beriberikix/spotmicro-arduino-q/stl/README.md

# Printable parts

Generated by `scripts/export_stls.py`; do not edit by hand.
Print every part without supports at 0.2 mm layers. Quantities are per robot.
`_mirrored` files are the mirrored copies of parts that come in pairs: normal files for the left legs, `_mirrored` for the right legs (the shoulder servo mount takes one of each per side).
Every part is in its print orientation, centred, with its lowest point at Z = 0.

Sources and licenses: Kooba's SpotMicroESP32 and robjk's reinforced shoulders (CC BY, Thingiverse
thing:4559827 and thing:4937631), the helper stand from Leika (stefi01, CC BY 4.0; Nova-SM2, MIT), and
`electronics/UnoQ_Mountingplate.stl` and `head/Sensormount_DualCam.stl` (this project, modified from Kooba,
CC BY-SA 4.0). See ../NOTICE.md.

## chassis

| File | Normal | Mirrored | Material | Infill | Notes |
| ---- | --- | --- | --- | --- | ----- |
| [Inner_Shoulder.stl](chassis/Inner_Shoulder.stl) | 2 | - | PLA | 20% |  |
| [Outer_Shoulder.stl](chassis/Outer_Shoulder.stl) | 2 | - | PLA | 20% |  |
| [Chassis_Side.stl](chassis/Chassis_Side.stl) | 2 | - | PLA | 20% |  |
| [Top_Shoulder.stl](chassis/Top_Shoulder.stl) | 2 | - | PLA | 20% |  |
| [Bottom_Shoulder.stl](chassis/Bottom_Shoulder.stl) | 2 | - | PLA | 20% |  |
| [LiPo_Mountingbracket_Front.stl](chassis/LiPo_Mountingbracket_Front.stl) | 1 | - | PLA | 20% |  |
| [LiPo_Mountingbracket_Middle.stl](chassis/LiPo_Mountingbracket_Middle.stl) | 1 | - | PLA | 20% |  |
| [LiPo_Mountingbracket_Rear.stl](chassis/LiPo_Mountingbracket_Rear.stl) | 1 | - | PLA | 20% |  |

## electronics

| File | Normal | Mirrored | Material | Infill | Notes |
| ---- | --- | --- | --- | --- | ----- |
| [UnoQ_Mountingplate.stl](electronics/UnoQ_Mountingplate.stl) | 1 | - | PLA | 20% | New: UNO Media Carrier + UNO Q + servo shield stack, SZBK07, GY-521 |

## shoulders

| File | Normal | Mirrored | Material | Infill | Notes |
| ---- | --- | --- | --- | --- | ----- |
| [Shoulder_Joint_Servomount_extended_BB.stl](shoulders/Shoulder_Joint_Servomount_extended_BB.stl) · [Shoulder_Joint_Servomount_extended_BB_mirrored.stl](shoulders/Shoulder_Joint_Servomount_extended_BB_mirrored.stl) | 2 | 2 | PLA | 20% | robjk |
| [Shoulder_Joint_Servo_Cap_Extended.stl](shoulders/Shoulder_Joint_Servo_Cap_Extended.stl) | 4 | - | PLA | 20% | robjk |
| [Shoulder_Cover.stl](shoulders/Shoulder_Cover.stl) | 4 | - | PLA | 20% | robjk; symmetric, no mirrored copy |
| [Shoulder_Joint_Ball_Bearing_Pin_M3x8.stl](shoulders/Shoulder_Joint_Ball_Bearing_Pin_M3x8.stl) | 4 | - | PLA | 20% | robjk; runs in the shoulder-cover bearing, M3x8 into the upper-leg shell |
| [Shoulder_Joint_Ball_Bearing_Pin.stl](shoulders/Shoulder_Joint_Ball_Bearing_Pin.stl) | 8 | - | PLA | 20% | 4 for the shoulder joints, 4 for the legs |

## legs

| File | Normal | Mirrored | Material | Infill | Notes |
| ---- | --- | --- | --- | --- | ----- |
| [Limb_Top_Shell_with_BB_hole.stl](legs/Limb_Top_Shell_with_BB_hole.stl) · [Limb_Top_Shell_with_BB_hole_mirrored.stl](legs/Limb_Top_Shell_with_BB_hole_mirrored.stl) | 2 | 2 | PLA | 20% | robjk; replaces Limb_Top_Shell |
| [Limb_Bottom_Shell.stl](legs/Limb_Bottom_Shell.stl) · [Limb_Bottom_Shell_mirrored.stl](legs/Limb_Bottom_Shell_mirrored.stl) | 2 | 2 | PLA | 20% |  |
| [Limb_Ball_Bearing_Mount_long_v4.stl](legs/Limb_Ball_Bearing_Mount_long_v4.stl) · [Limb_Ball_Bearing_Mount_long_v4_mirrored.stl](legs/Limb_Ball_Bearing_Mount_long_v4_mirrored.stl) | 2 | 2 | PLA | 20% |  |
| [Limb_Servohorn_Mount_long_v4.stl](legs/Limb_Servohorn_Mount_long_v4.stl) · [Limb_Servohorn_Mount_long_v4_mirrored.stl](legs/Limb_Servohorn_Mount_long_v4_mirrored.stl) | 2 | 2 | PLA | 20% |  |
| [Wrist.stl](legs/Wrist.stl) · [Wrist_mirrored.stl](legs/Wrist_mirrored.stl) | 2 | 2 | PLA | 20% |  |
| [Wrist_Counterpart.stl](legs/Wrist_Counterpart.stl) · [Wrist_Counterpart_mirrored.stl](legs/Wrist_Counterpart_mirrored.stl) | 2 | 2 | PLA | 20% |  |
| [Foot_Tip.stl](legs/Foot_Tip.stl) | 4 | - | TPU | 20% |  |

## hull

| File | Normal | Mirrored | Material | Infill | Notes |
| ---- | --- | --- | --- | --- | ----- |
| [Top_Cover_Split_Front.stl](hull/Top_Cover_Split_Front.stl) | 1 | - | PLA | 100% |  |
| [Top_Cover_Split_Rear_with_OLED.stl](hull/Top_Cover_Split_Rear_with_OLED.stl) | 1 | - | PLA | 100% |  |
| [Bottom_Cover_Split_Front.stl](hull/Bottom_Cover_Split_Front.stl) | 1 | - | PLA | 100% |  |
| [Bottom_Cover_Split_Rear.stl](hull/Bottom_Cover_Split_Rear.stl) | 1 | - | PLA | 100% |  |
| [Rear_Cover_Shell_Long.stl](hull/Rear_Cover_Shell_Long.stl) | 1 | - | PLA | 100% |  |
| [Rear_Cover_Plate.stl](hull/Rear_Cover_Plate.stl) | 1 | - | PLA | 100% |  |

## head

| File | Normal | Mirrored | Material | Infill | Notes |
| ---- | --- | --- | --- | --- | ----- |
| [Front_Cover_Optimized.stl](head/Front_Cover_Optimized.stl) | 1 | - | PLA | 100% |  |
| [Sensormount_DualCam.stl](head/Sensormount_DualCam.stl) | 1 | - | PLA | 20% | New: Kooba's sensor mount, holding two Raspberry Pi Camera Module 2s |

## optional/servo-horns

| File | Normal | Mirrored | Material | Infill | Notes |
| ---- | --- | --- | --- | --- | ----- |
| [Servohorn_6_B_Star.stl](optional/servo-horns/Servohorn_6_B_Star.stl) | 12 | - | PLA | 20% | Only if your servos lack FSH6S-type horns |

## optional/rear-cover-medium

| File | Normal | Mirrored | Material | Infill | Notes |
| ---- | --- | --- | --- | --- | ----- |
| [Rear_Cover_Shell_Medium.stl](optional/rear-cover-medium/Rear_Cover_Shell_Medium.stl) | 1 | - | PLA | 100% | robjk; shorter alternative to Rear_Cover_Shell_Long |
| [Rear_Cover_Plate_Medium.stl](optional/rear-cover-medium/Rear_Cover_Plate_Medium.stl) | 1 | - | PLA | 100% | robjk; pairs with Rear_Cover_Shell_Medium; OLED and 2x GX16 cut-outs |

## optional/helper-stand

| File | Normal | Mirrored | Material | Infill | Notes |
| ---- | --- | --- | --- | --- | ----- |
| [Stand_Top.stl](optional/helper-stand/Stand_Top.stl) | 2 | - | PLA | 20% | stefi01 |
| [Stand_Bottom.stl](optional/helper-stand/Stand_Bottom.stl) | 2 | - | PLA | 20% | Nova-SM2 |
| [Stand_Brace.stl](optional/helper-stand/Stand_Brace.stl) | 2 | - | PLA | 20% | Nova-SM2 |
| [Stand_Feet.stl](optional/helper-stand/Stand_Feet.stl) | 4 | - | PLA | 20% | Nova-SM2 |

## optional/test-prints

| File | Normal | Mirrored | Material | Infill | Notes |
| ---- | --- | --- | --- | --- | ----- |
| [Carrier_Mount_Test.stl](optional/test-prints/Carrier_Mount_Test.stl) | 1 | - | PLA | 20% | Media Carrier pads, hooks and snap clips from the electronics plate |
| [SZBK07_Mount_Test.stl](optional/test-prints/SZBK07_Mount_Test.stl) | 1 | - | PLA | 20% | SZBK07 posts from the electronics plate |

Required prints: 74 parts.
