beriberikix/spotmicro-arduino-q/docs/images/spot-unoq-iso.png

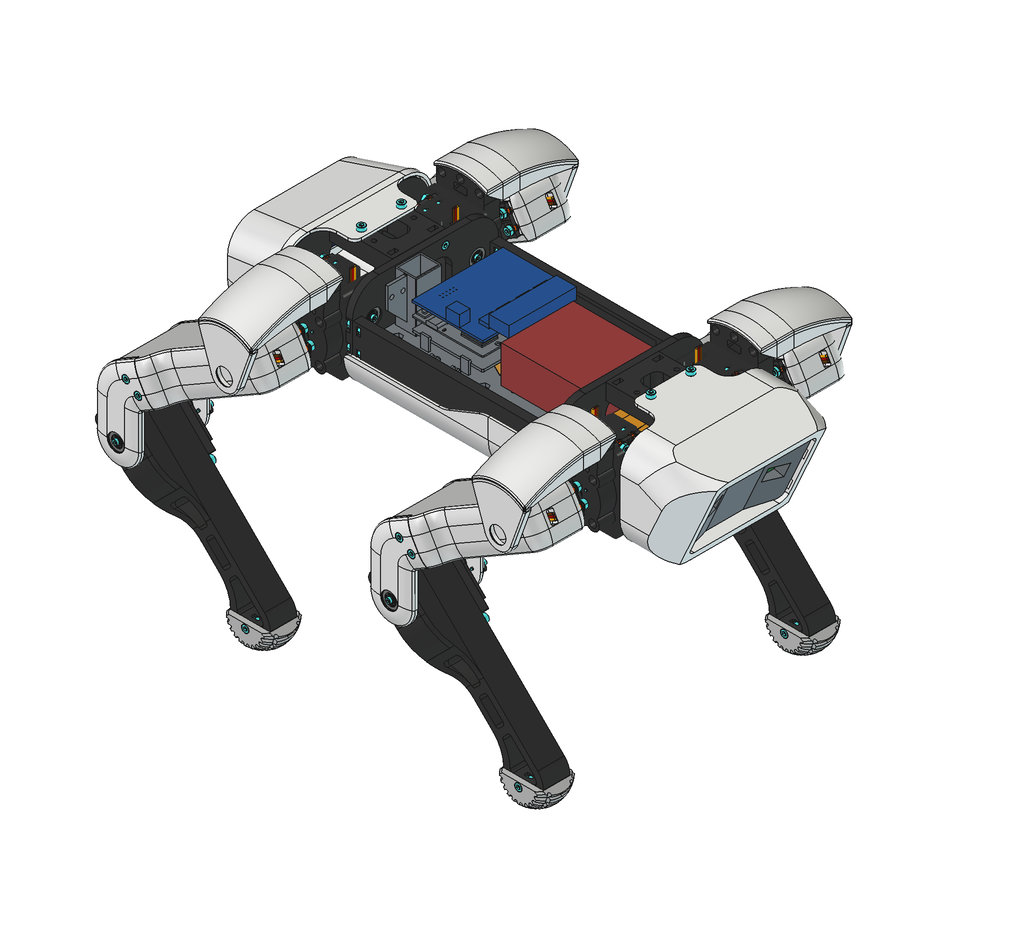
docs/images/spot-unoq-iso.png
