beriberikix/spotmicro-arduino-q/cad/UnoQ_Mountingplate.FCStd

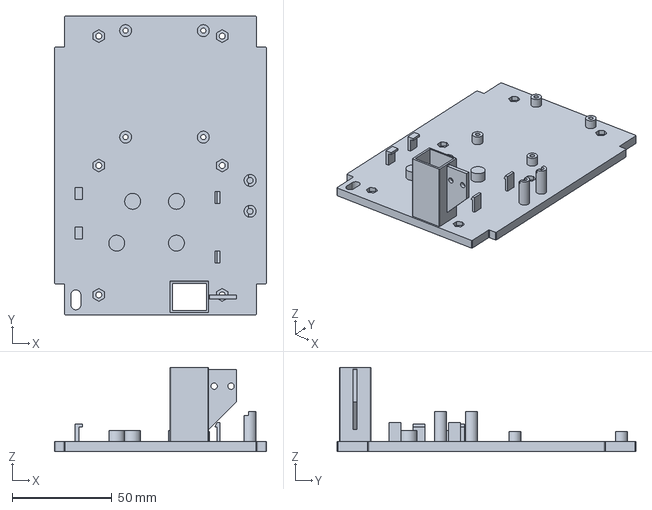
[picture p6: CAD file, 2026-11-11]
cad/UnoQ_Mountingplate.FCStd
106.5 x 150.0 x 42.2 mm
