beriberikix/spotmicro-arduino-q/step/chassis/LiPo_Mountingbracket_Middle.step

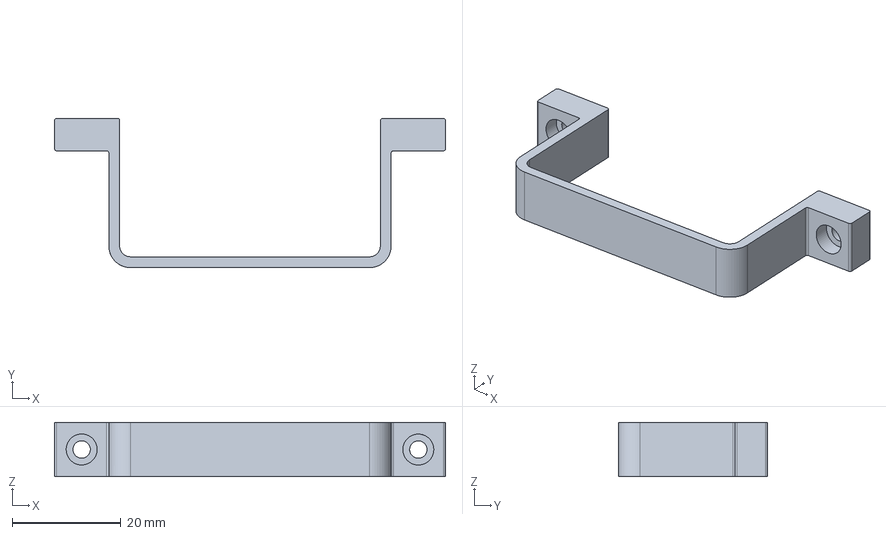
[picture p7: CAD file, 2026-11-10]
step/chassis/LiPo_Mountingbracket_Middle.step
72.0 x 27.5 x 10.0 mm
