beriberikix/spotmicro-arduino-q/step/head/Sensormount_DualCam.step

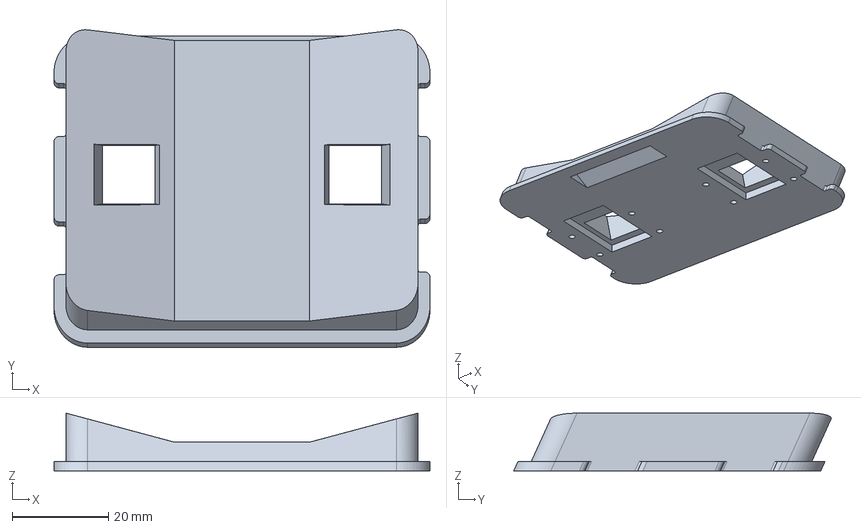
[picture p8: CAD file, 2026-11-11]
step/head/Sensormount_DualCam.step
78.0 x 65.9 x 12.0 mm
