beriberikix/spotmicro-arduino-q/step/hull/Top_Cover_Split_Rear_with_OLED.step

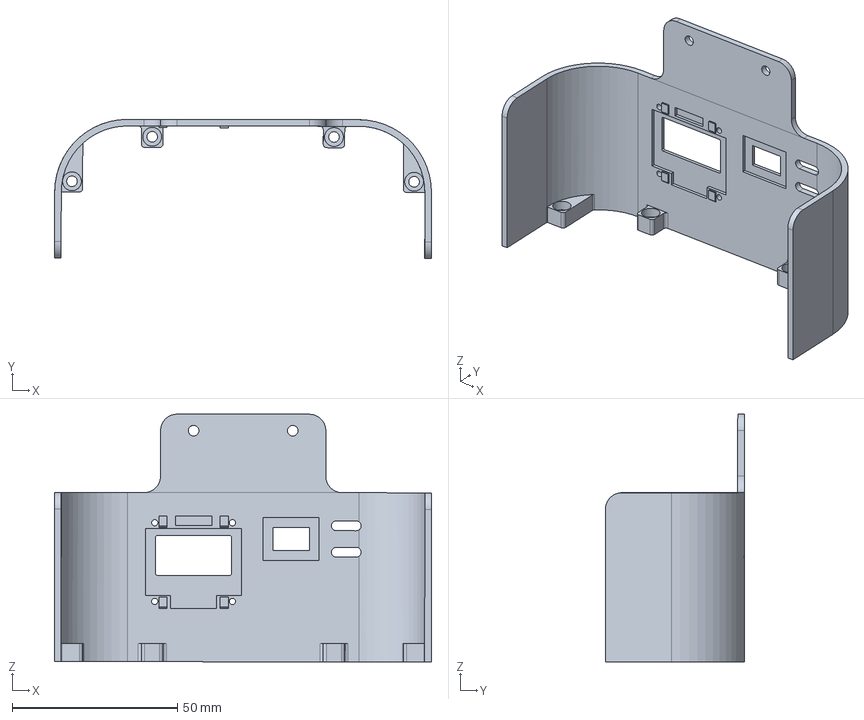
[picture p9: CAD file, 2026-11-10]
step/hull/Top_Cover_Split_Rear_with_OLED.step
114.1 x 42.1 x 74.9 mm
