beriberikix/spotmicro-arduino-q/step/legs/Wrist_Counterpart.step

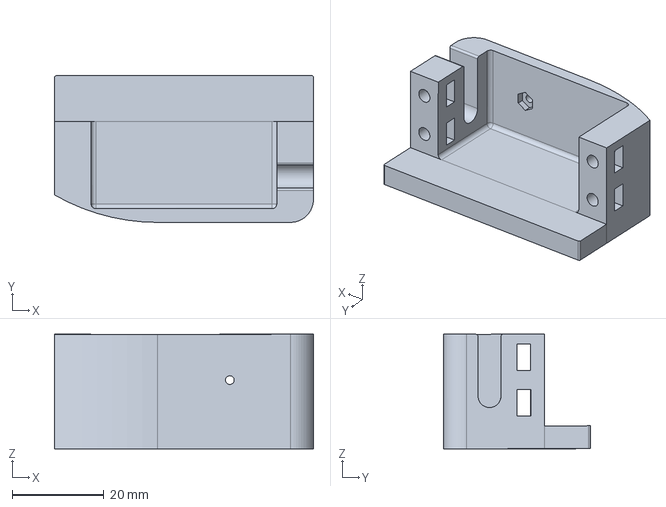
[picture p10: CAD file, 2026-11-10]
step/legs/Wrist_Counterpart.step
56.5 x 32.0 x 25.0 mm
