beriberikix/spotmicro-arduino-q/step/optional/rear-cover-medium/Rear_Cover_Plate_Medium.step

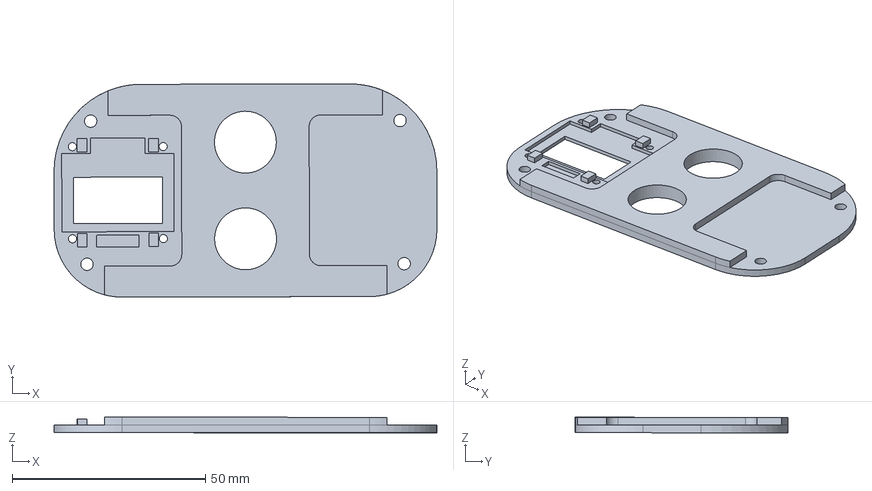
[picture p11: CAD file, 2026-11-10]
step/optional/rear-cover-medium/Rear_Cover_Plate_Medium.step
99.0 x 55.1 x 4.02 mm
