beriberikix/spotmicro-arduino-q/step/optional/servo-horns/Servohorn_6_B_Star.step

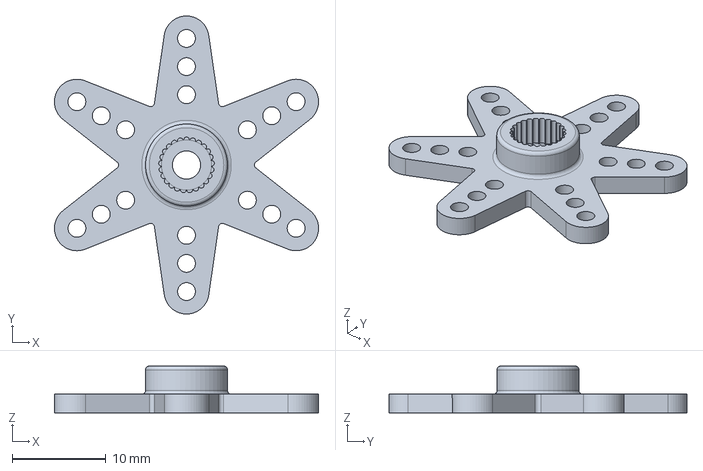
[picture p12: CAD file, 2026-11-10]
step/optional/servo-horns/Servohorn_6_B_Star.step
28.2 x 31.8 x 5.01 mm
