beriberikix/spotmicro-arduino-q/step/shoulders/Shoulder_Cover.step

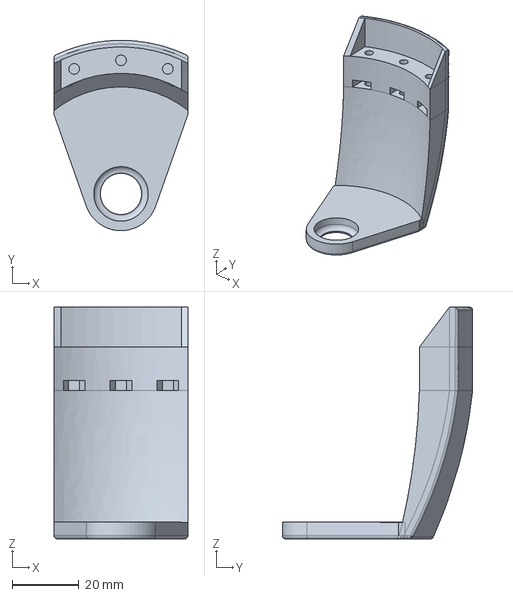
[picture p13: CAD file, 2026-11-10]
step/shoulders/Shoulder_Cover.step
40.0 x 56.9 x 69.3 mm
