beriberikix/spotmicro-arduino-q/stl/optional/helper-stand/Stand_Brace.stl

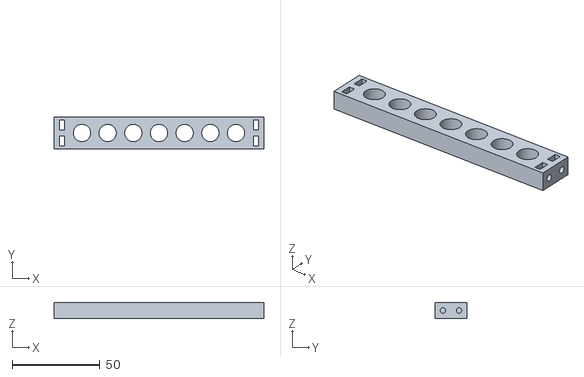
[picture p14: CAD file, 2026-11-09]
stl/optional/helper-stand/Stand_Brace.stl
120.0 x 18.4 x 9.20
