beriberikix/spotmicro-arduino-q/stl/optional/test-prints/SZBK07_Mount_Test.stl

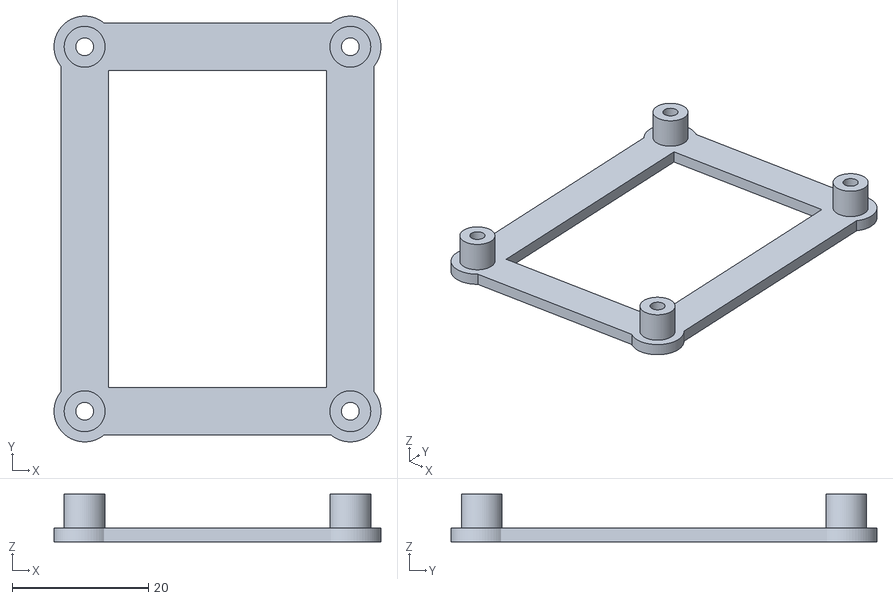
[picture p15: CAD file, 2026-11-11]
stl/optional/test-prints/SZBK07_Mount_Test.stl
48.0 x 62.5 x 7.00
