beriberikix/spotmicro-arduino-q/stl/shoulders/Shoulder_Joint_Servomount_extended_BB_mirrored.stl

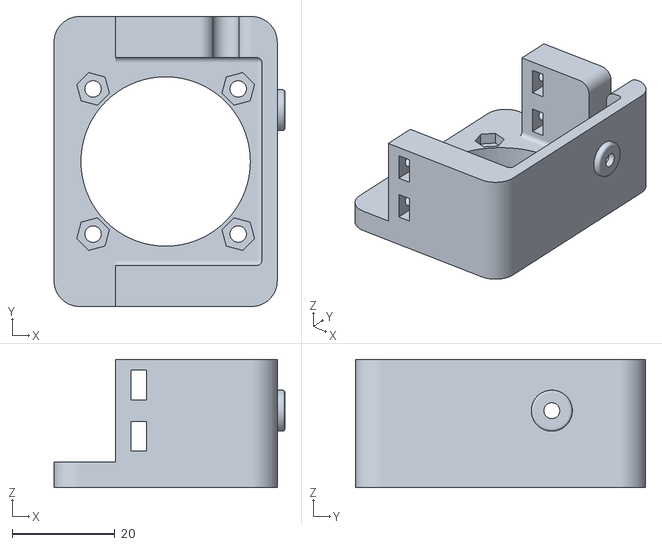
[picture p16: CAD file, 2026-11-09]
stl/shoulders/Shoulder_Joint_Servomount_extended_BB_mirrored.stl
45.0 x 56.5 x 25.0
