beriberikix/spotmicro-arduino-q/cad/SpotUnoQ.FCStd

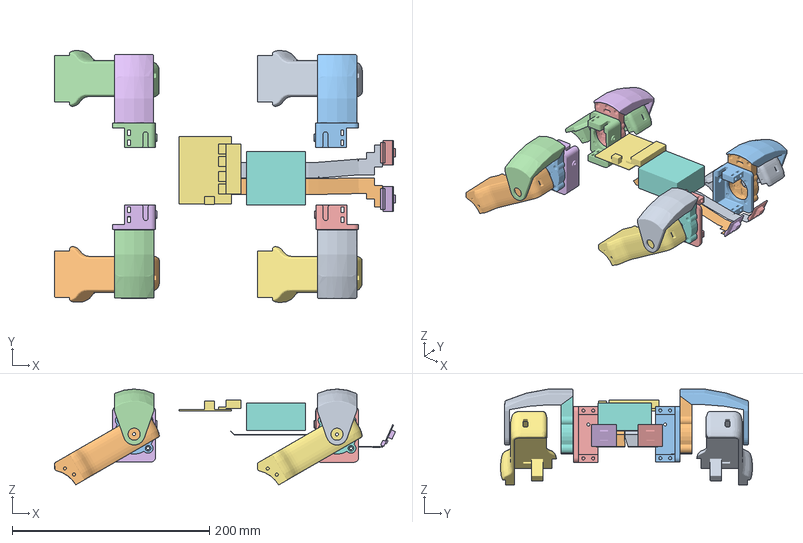
[picture p17: CAD file, 2026-11-11]
cad/SpotUnoQ.FCStd
346.0 x 255.2 x 97.4 mm
robjk_shell_FL
robjk_cap_FL
robjk_cover_FL
robjk_shell_RL
robjk_cap_RL
robjk_cover_RL
robjk_shell_FR
robjk_cap_FR
robjk_cover_FR
robjk_shell_RR
robjk_cap_RR
robjk_cover_RR
Raspberry Pi Camera Module 2 (left, placeholder)
Raspberry Pi Camera Module 2 (right, placeholder)
Adafruit 1411 servo shield + right-angle plugs (placeholder)
SZBK07 20 A buck, 60x54x28 (placeholder)
Camera cable left: Standard-Mini 200 mm (route, 172 mm used)
Camera cable right: Standard-Mini 200 mm (route, 171 mm used)
robjk_servomount_FL
robjk_servomount_RL
robjk_servomount_FR
robjk_servomount_RR
