beriberikix/spotmicro-arduino-q/step/chassis/Chassis_Side.step

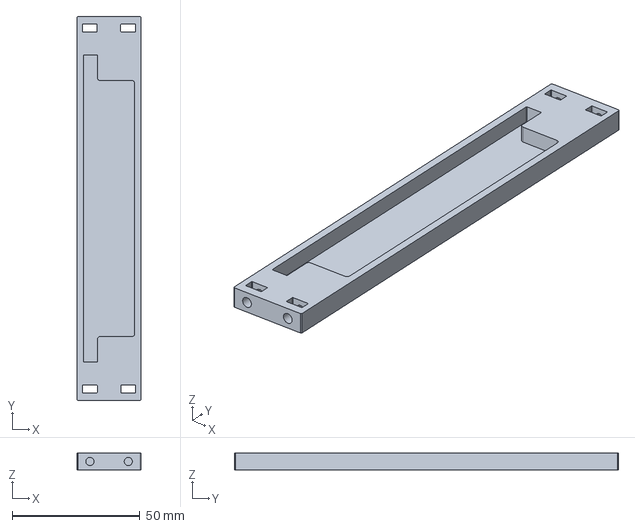
[picture p18: CAD file, 2026-11-10]
step/chassis/Chassis_Side.step
25.1 x 150.0 x 6.51 mm
