beriberikix/spotmicro-arduino-q/step/head/Front_Cover_Optimized.step

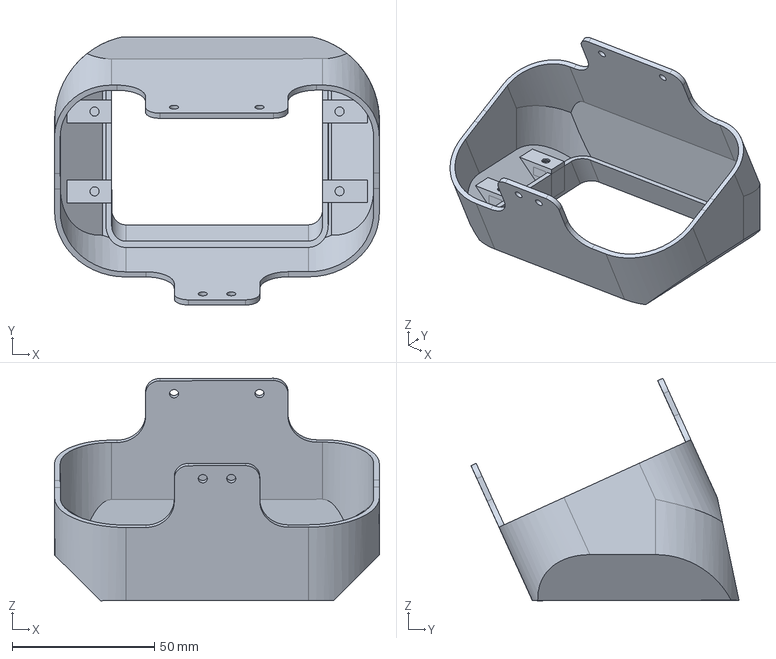
[picture p19: CAD file, 2026-11-10]
step/head/Front_Cover_Optimized.step
114.1 x 94.1 x 78.1 mm
