beriberikix/spotmicro-arduino-q/step/hull/Rear_Cover_Shell_Long.step

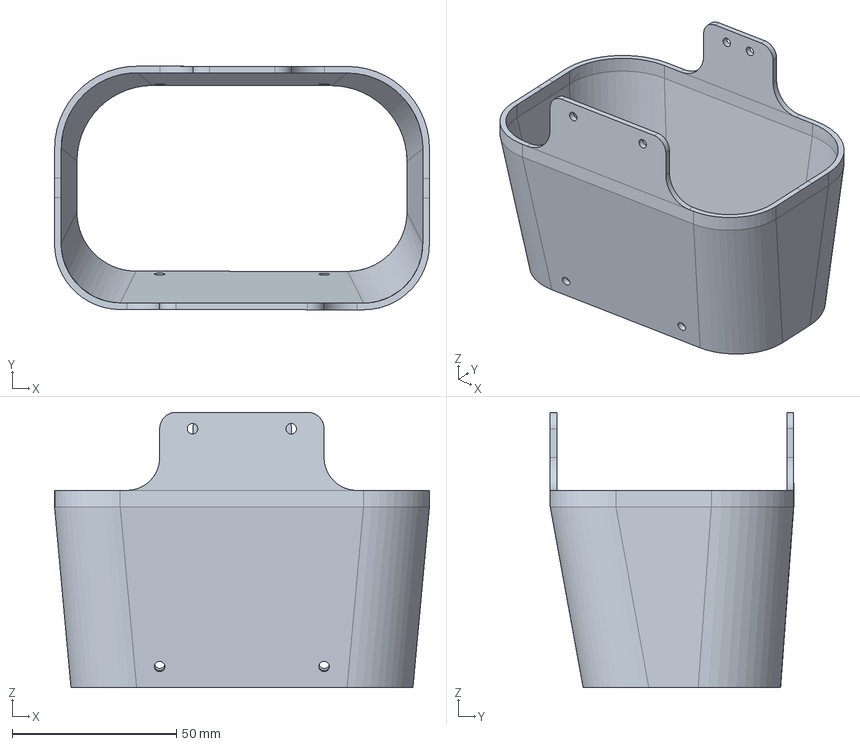
[picture p20: CAD file, 2026-11-10]
step/hull/Rear_Cover_Shell_Long.step
114.0 x 74.1 x 83.8 mm
