beriberikix/spotmicro-arduino-q/step/legs/Limb_Bottom_Shell.step

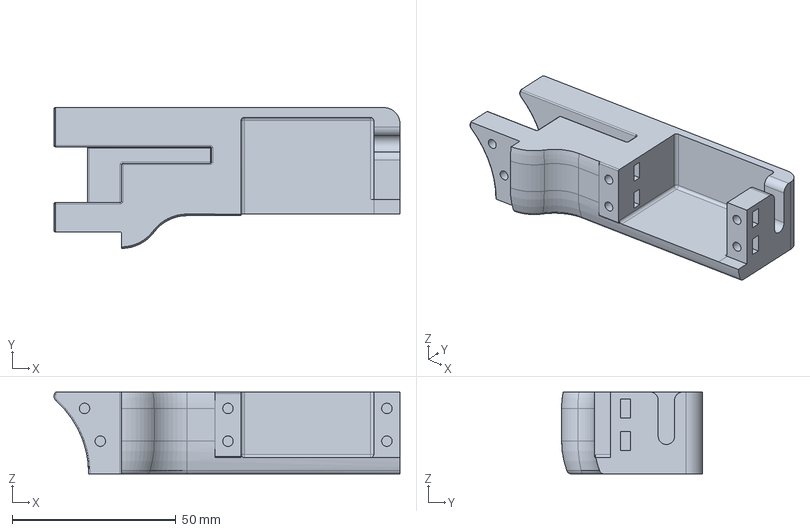
[picture p21: CAD file, 2026-11-10]
step/legs/Limb_Bottom_Shell.step
105.6 x 43.0 x 25.0 mm
