beriberikix/spotmicro-arduino-q/step/optional/rear-cover-medium/Rear_Cover_Shell_Medium.step

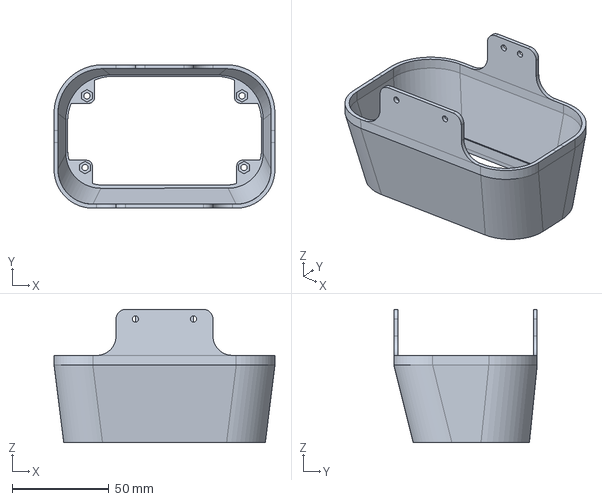
[picture p22: CAD file, 2026-11-10]
step/optional/rear-cover-medium/Rear_Cover_Shell_Medium.step
114.0 x 74.0 x 68.8 mm
