beriberikix/spotmicro-arduino-q/step/shoulders/Shoulder_Joint_Ball_Bearing_Pin.step

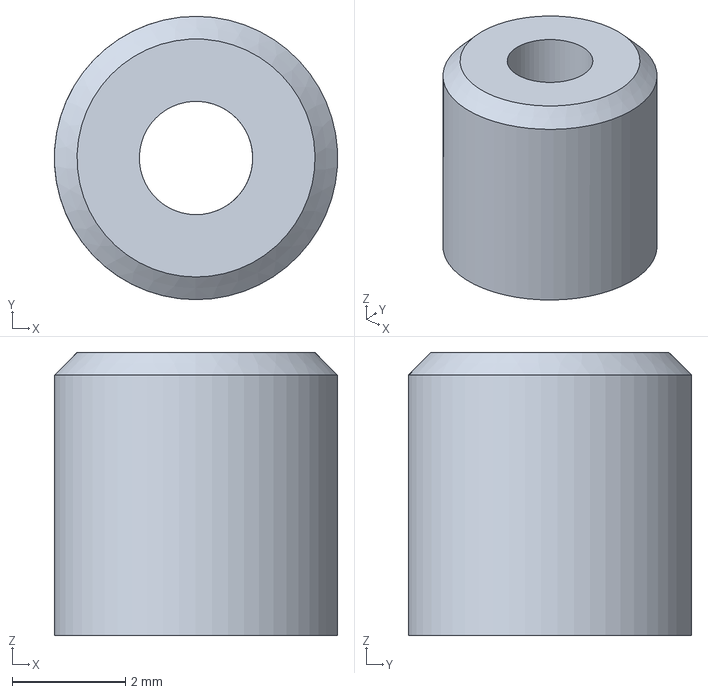
[picture p23: CAD file, 2026-11-10]
step/shoulders/Shoulder_Joint_Ball_Bearing_Pin.step
4.99 x 5.00 x 5.00 mm
