beriberikix/spotmicro-arduino-q/stl/optional/helper-stand/Stand_Bottom.stl

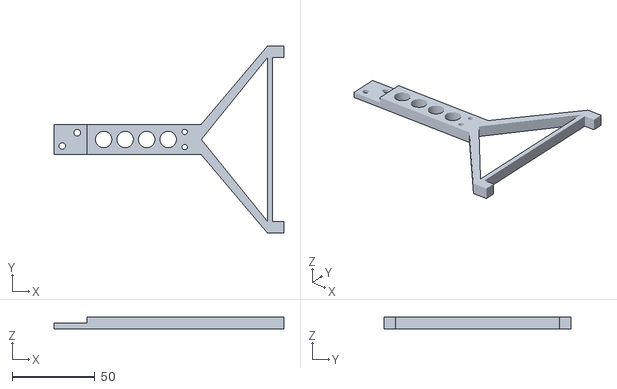
[picture p24: CAD file, 2026-11-09]
stl/optional/helper-stand/Stand_Bottom.stl
139.0 x 113.0 x 7.00
