beriberikix/spotmicro-arduino-q/stl/optional/test-prints/Carrier_Mount_Test.stl

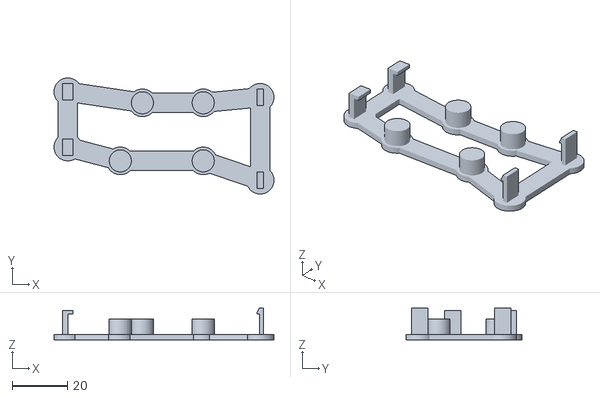
[picture p25: CAD file, 2026-11-11]
stl/optional/test-prints/Carrier_Mount_Test.stl
79.6 x 42.0 x 11.5
