beriberikix/spotmicro-arduino-q/stl/shoulders/Shoulder_Joint_Ball_Bearing_Pin_M3x8.stl

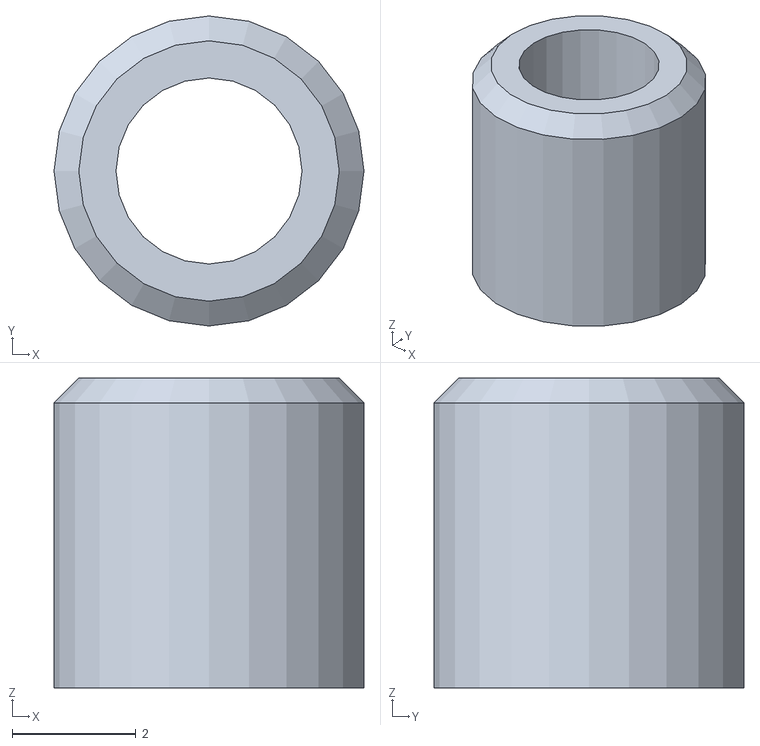
[picture p26: CAD file, 2026-11-09]
stl/shoulders/Shoulder_Joint_Ball_Bearing_Pin_M3x8.stl
5.00 x 5.00 x 5.00
