beriberikix/spotmicro-arduino-q/step/chassis/Bottom_Shoulder.step

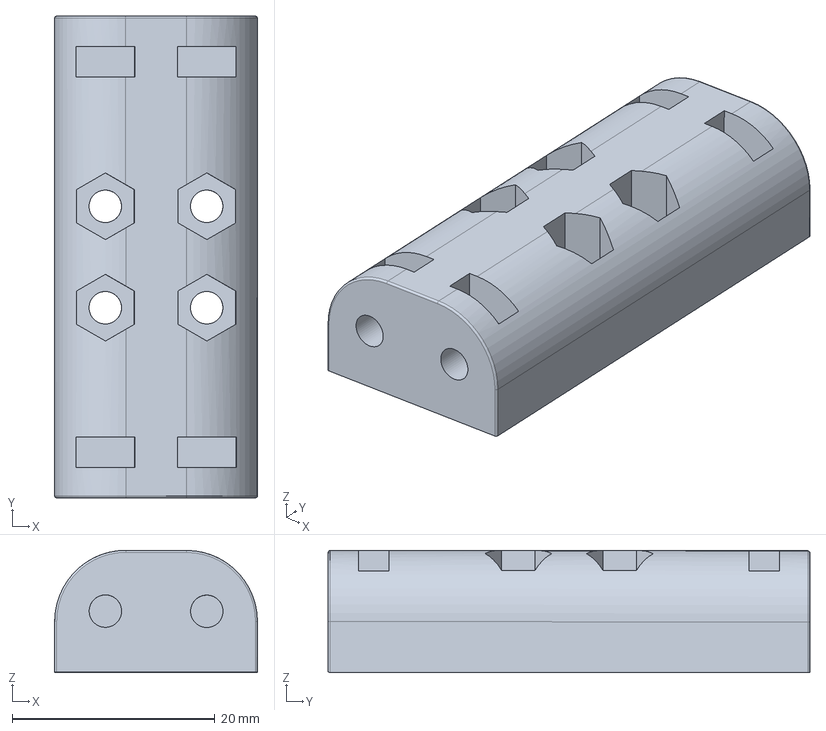
[picture p27: CAD file, 2026-11-10]
step/chassis/Bottom_Shoulder.step
20.0 x 47.5 x 12.1 mm
