beriberikix/spotmicro-arduino-q/step/hull/Bottom_Cover_Split_Front.step

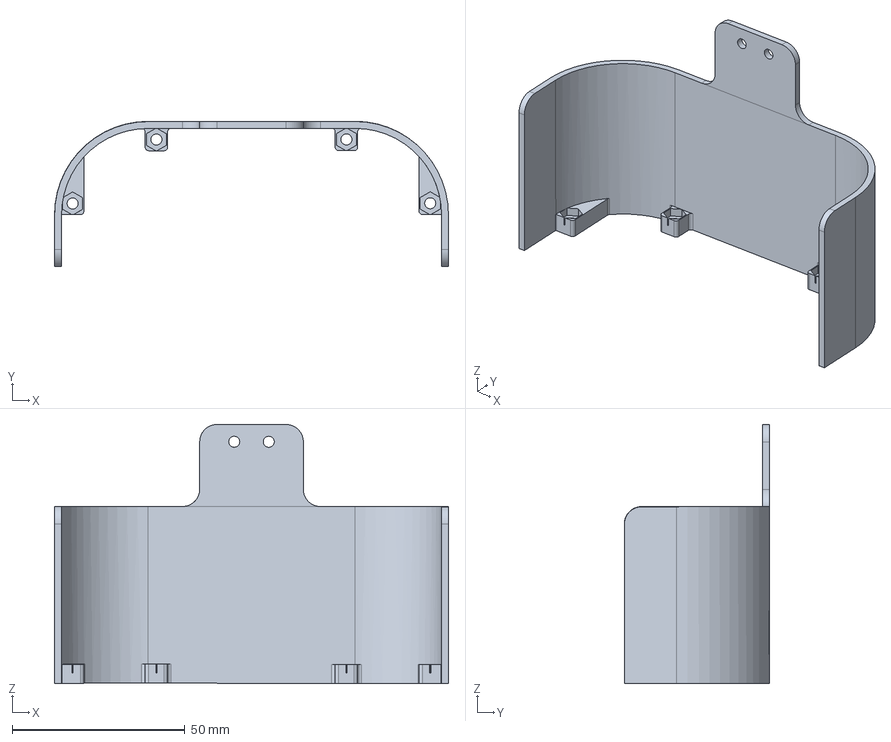
[picture p28: CAD file, 2026-11-10]
step/hull/Bottom_Cover_Split_Front.step
114.0 x 42.1 x 75.0 mm
