beriberikix/spotmicro-arduino-q/step/legs/Limb_Top_Shell_with_BB_hole.step

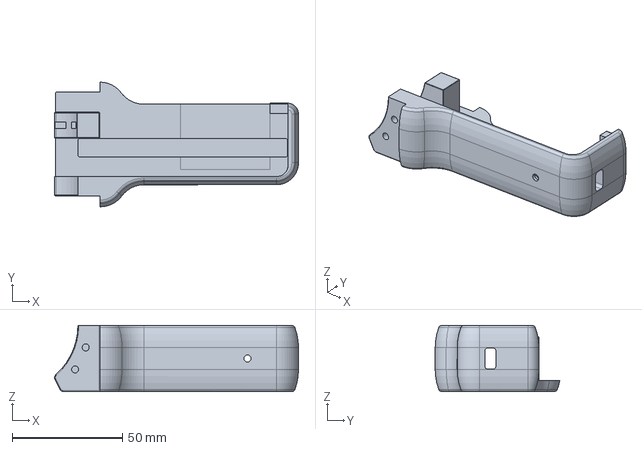
[picture p29: CAD file, 2026-11-10]
step/legs/Limb_Top_Shell_with_BB_hole.step
110.6 x 56.5 x 30.1 mm
