beriberikix/spotmicro-arduino-q/step/shoulders/Shoulder_Joint_Servo_Cap_Extended.step

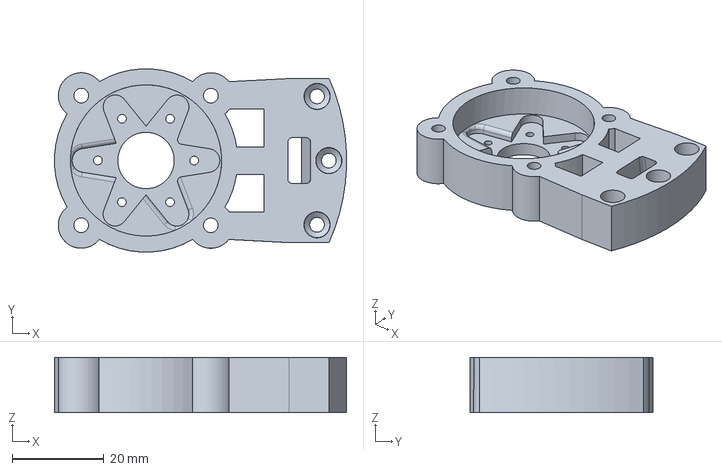
[picture p30: CAD file, 2026-11-10]
step/shoulders/Shoulder_Joint_Servo_Cap_Extended.step
63.7 x 39.9 x 12.0 mm
