beriberikix/spotmicro-arduino-q/stl/optional/helper-stand/Stand_Feet.stl

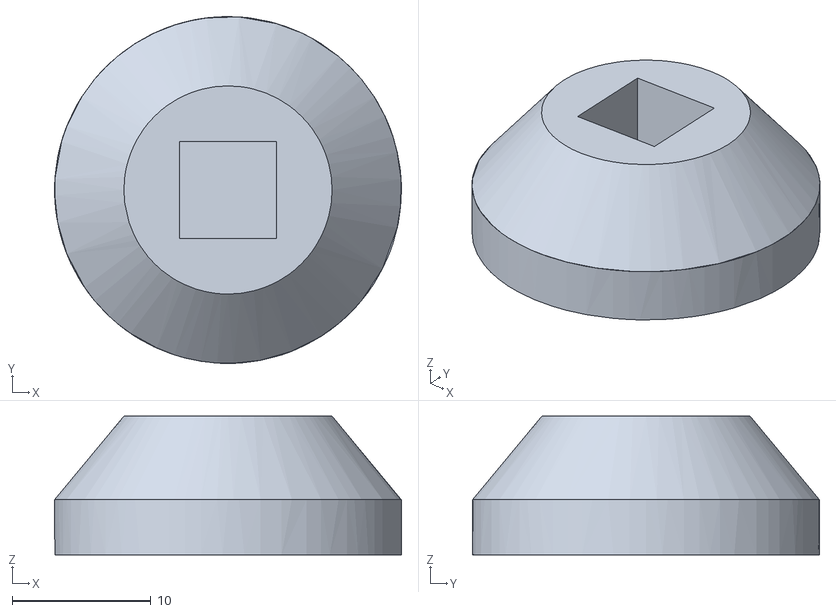
[picture p31: CAD file, 2026-11-09]
stl/optional/helper-stand/Stand_Feet.stl
25.0 x 25.0 x 10.0
