beriberikix/spotmicro-arduino-q/step/chassis/LiPo_Mountingbracket_Front.step

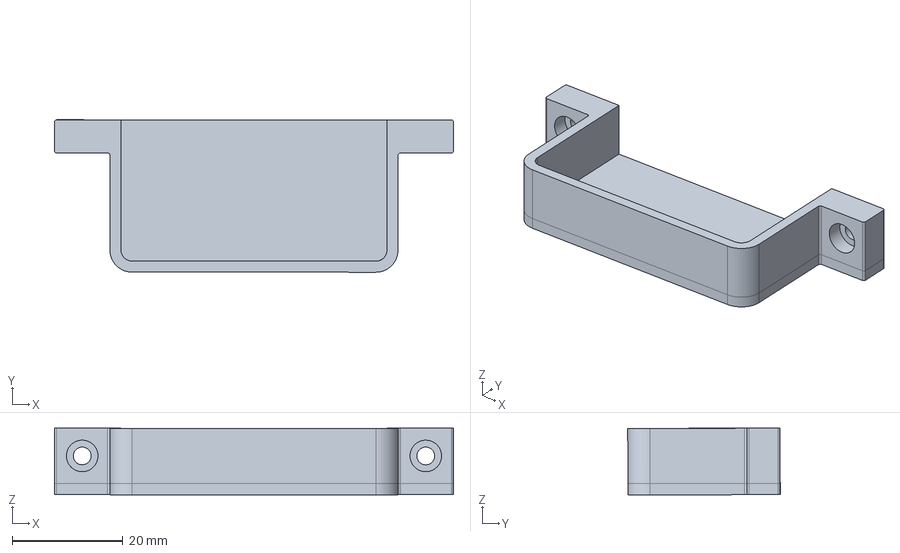
[picture p32: CAD file, 2026-11-10]
step/chassis/LiPo_Mountingbracket_Front.step
72.0 x 27.5 x 12.0 mm
