beriberikix/spotmicro-arduino-q/step/hull/Bottom_Cover_Split_Rear.step

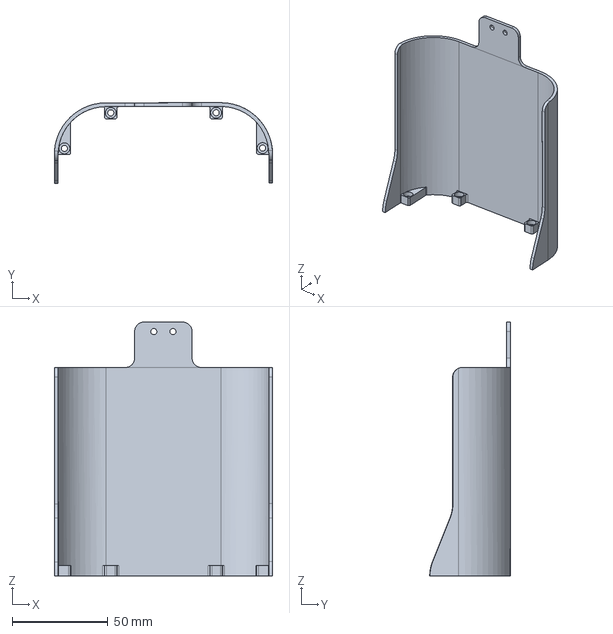
[picture p33: CAD file, 2026-11-10]
step/hull/Bottom_Cover_Split_Rear.step
114.1 x 42.1 x 132.6 mm
