beriberikix/spotmicro-arduino-q/step/legs/Limb_Ball_Bearing_Mount_long_v4.step

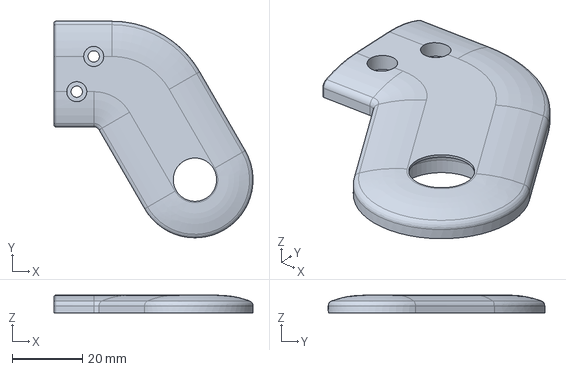
[picture p34: CAD file, 2026-11-10]
step/legs/Limb_Ball_Bearing_Mount_long_v4.step
56.5 x 61.5 x 5.00 mm
