beriberikix/spotmicro-arduino-q/stl/optional/helper-stand/Stand_Top.stl

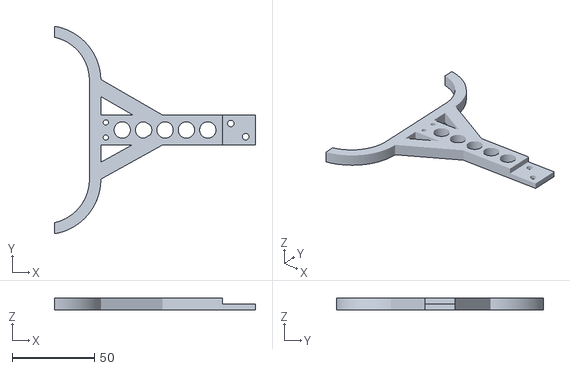
[picture p35: CAD file, 2026-11-09]
stl/optional/helper-stand/Stand_Top.stl
122.2 x 126.2 x 7.00
