beriberikix/spotmicro-arduino-q/step/chassis/Top_Shoulder.step

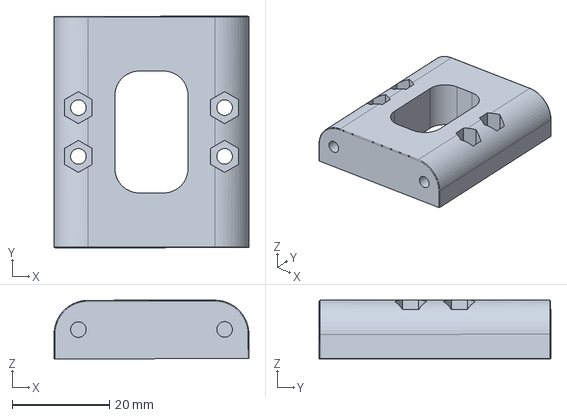
[picture p36: CAD file, 2026-11-10]
step/chassis/Top_Shoulder.step
40.0 x 47.5 x 12.0 mm
