beriberikix/spotmicro-arduino-q/step/hull/Top_Cover_Split_Front.step

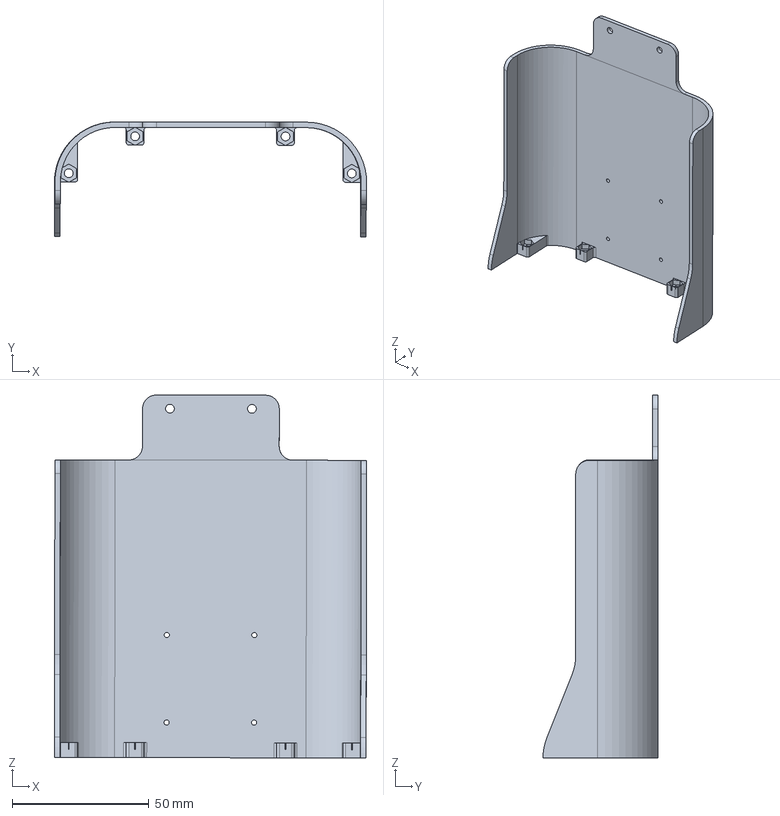
[picture p37: CAD file, 2026-11-10]
step/hull/Top_Cover_Split_Front.step
114.2 x 42.1 x 132.7 mm
