beriberikix/spotmicro-arduino-q/step/chassis/Outer_Shoulder.step

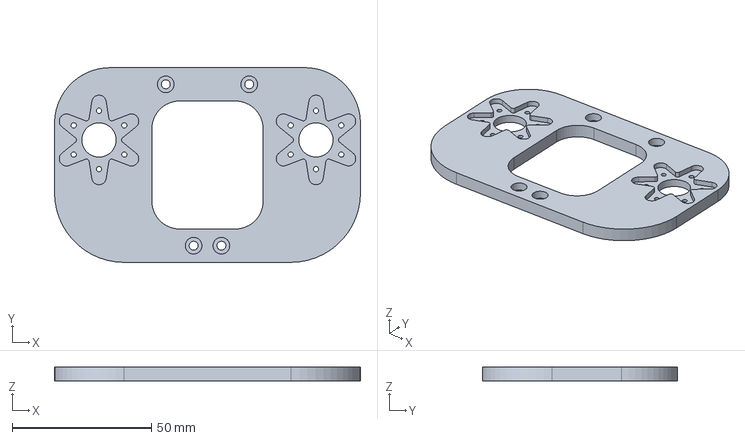
[picture p38: CAD file, 2026-11-10]
step/chassis/Outer_Shoulder.step
110.0 x 70.0 x 5.02 mm
