beriberikix/spotmicro-arduino-q/step/hull/Rear_Cover_Plate.step

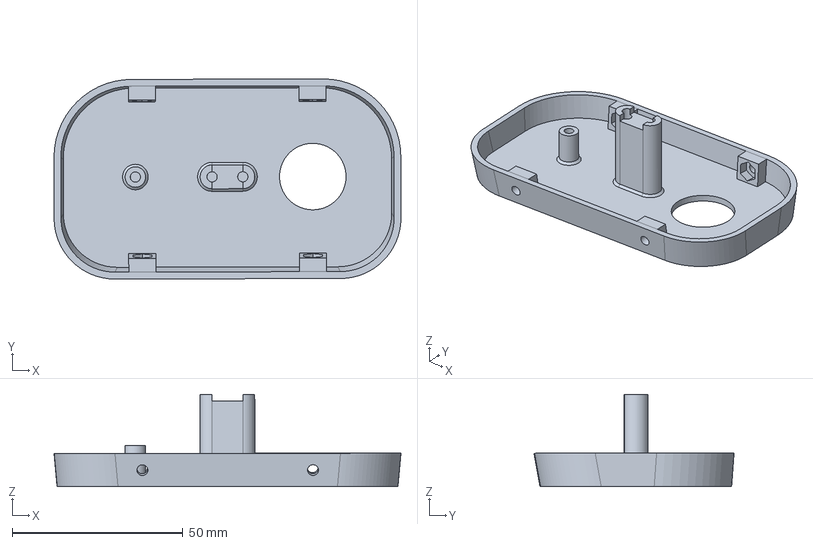
[picture p39: CAD file, 2026-11-10]
step/hull/Rear_Cover_Plate.step
101.7 x 58.7 x 27.0 mm
