beriberikix/spotmicro-arduino-q/step/legs/Wrist_mirrored.step

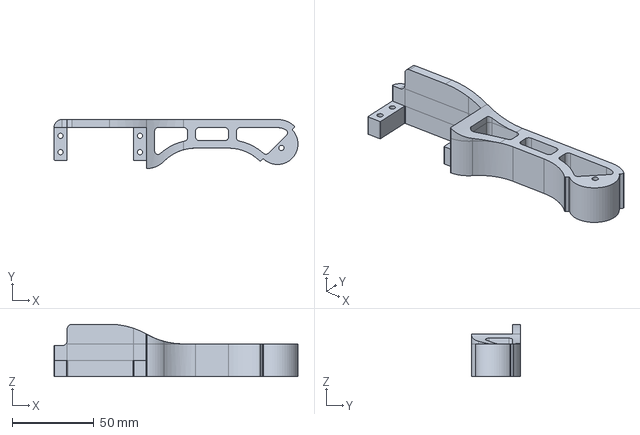
[picture p40: CAD file, 2026-11-10]
step/legs/Wrist_mirrored.step
149.0 x 30.0 x 32.0 mm
