beriberikix/spotmicro-arduino-q/step/chassis/LiPo_Mountingbracket_Rear.step

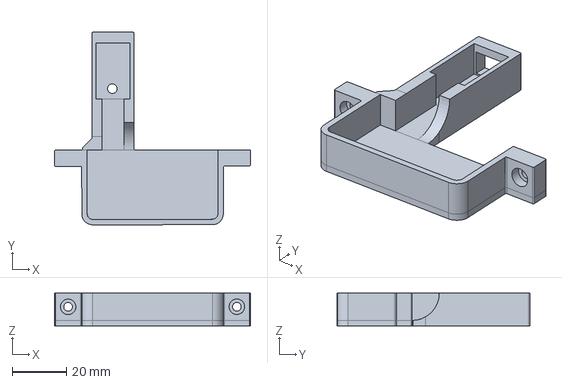
[picture p41: CAD file, 2026-11-10]
step/chassis/LiPo_Mountingbracket_Rear.step
72.0 x 70.8 x 12.0 mm
