beriberikix/spotmicro-arduino-q/step/legs/Foot_Tip.step

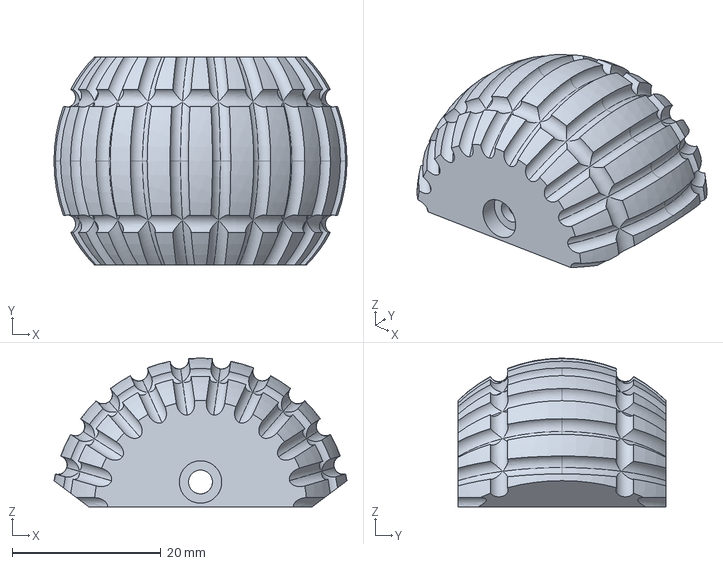
[picture p42: CAD file, 2026-11-10]
step/legs/Foot_Tip.step
39.4 x 28.0 x 20.0 mm
