beriberikix/spotmicro-arduino-q/step/legs/Limb_Servohorn_Mount_long_v4_mirrored.step

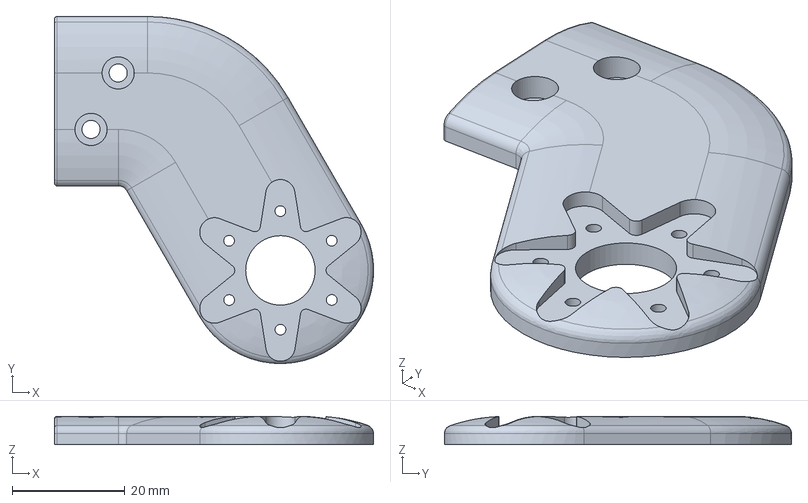
[picture p43: CAD file, 2026-11-10]
step/legs/Limb_Servohorn_Mount_long_v4_mirrored.step
56.5 x 61.5 x 5.00 mm
