beriberikix/spotmicro-arduino-q/(list of files, cad)

Other CAD files:
step/electronics/UnoQ_Mountingplate.step
cad/Sensormount_DualCam.FCStd
stl/shoulders/Shoulder_Joint_Servomount_extended_BB.stl
step/legs/Limb_Bottom_Shell_mirrored.step
step/legs/Wrist_Counterpart_mirrored.step
step/chassis/Inner_Shoulder.step
step/legs/Limb_Top_Shell_with_BB_hole_mirrored.step
step/legs/Wrist.step
step/legs/Limb_Ball_Bearing_Mount_long_v4_mirrored.step
step/legs/Limb_Servohorn_Mount_long_v4.step
stl/chassis/Bottom_Shoulder.stl
stl/chassis/Chassis_Side.stl
stl/chassis/Inner_Shoulder.stl
stl/chassis/LiPo_Mountingbracket_Front.stl
stl/chassis/LiPo_Mountingbracket_Middle.stl
stl/chassis/LiPo_Mountingbracket_Rear.stl
stl/chassis/Outer_Shoulder.stl
stl/chassis/Top_Shoulder.stl
stl/electronics/UnoQ_Mountingplate.stl
stl/head/Front_Cover_Optimized.stl
stl/head/Sensormount_DualCam.stl
stl/hull/Bottom_Cover_Split_Front.stl
stl/hull/Bottom_Cover_Split_Rear.stl
stl/hull/Rear_Cover_Plate.stl
stl/hull/Rear_Cover_Shell_Long.stl
stl/hull/Top_Cover_Split_Front.stl
stl/hull/Top_Cover_Split_Rear_with_OLED.stl
stl/legs/Foot_Tip.stl
stl/legs/Limb_Ball_Bearing_Mount_long_v4.stl
stl/legs/Limb_Ball_Bearing_Mount_long_v4_mirrored.stl
stl/legs/Limb_Bottom_Shell.stl
stl/legs/Limb_Bottom_Shell_mirrored.stl
stl/legs/Limb_Servohorn_Mount_long_v4.stl
stl/legs/Limb_Servohorn_Mount_long_v4_mirrored.stl
stl/legs/Limb_Top_Shell_with_BB_hole.stl
stl/legs/Limb_Top_Shell_with_BB_hole_mirrored.stl
stl/legs/Wrist.stl
stl/legs/Wrist_Counterpart.stl
stl/legs/Wrist_Counterpart_mirrored.stl
stl/legs/Wrist_mirrored.stl
stl/optional/rear-cover-medium/Rear_Cover_Plate_Medium.stl
stl/optional/rear-cover-medium/Rear_Cover_Shell_Medium.stl
stl/optional/servo-horns/Servohorn_6_B_Star.stl
stl/shoulders/Shoulder_Cover.stl
stl/shoulders/Shoulder_Joint_Ball_Bearing_Pin.stl
stl/shoulders/Shoulder_Joint_Servo_Cap_Extended.stl
