beriberikix/spotmicro-arduino-q/firmware/servo_tool/servo_tool.ino

// servo_tool: test, centre and pre-position the twelve leg servos before assembly.
//
// Hardware: Arduino UNO Q + Adafruit 16-channel PWM/Servo Shield (PCA9685 at 0x40) on its headers,
// SZBK07 set to 6.0 V on the shield's V+ terminal. DS3218 180-degree servos (500-2500 us).
// Build guide: https://beriberikix.github.io/spotmicro-arduino-q/prepare/servos/
//
// Open the Serial Monitor (App Lab: Console > Serial Monitor), type a command and press Enter:
//   h              help and channel map
//   c              centre every channel (90 deg, 1500 us)
//   a              assembly angles (shoulders 90, hips L120/R60, knees L180/R0)
//   a <ch>         assembly angle for one channel
//   s <ch> <deg>   set one channel to an angle (0-180)
//   u <ch> <us>    set one channel to a pulse width in microseconds (500-2500)
//   t <ch>         test: sweep one channel 45-135 deg twice, then back to 90
//   o              all outputs off (servos go limp)
//   o <ch>         one output off
// Nothing moves until you type a command: at power-up every output is off.
//
// MIT License, see ../../LICENSE.

#include <Wire.h>
#include <Adafruit_PWMServoDriver.h>

Adafruit_PWMServoDriver pwm(0x40, Wire);

const uint16_t US_MIN = 500;     // pulse at 0 deg
const uint16_t US_MAX = 2500;    // pulse at 180 deg
const uint8_t CHANNELS = 12;

// Channel map (shield channel -> joint). The firmware will use the same order.
struct Joint {
  const char *name;
  uint8_t assembly_deg;  // angle the servo must be at when its horn is fitted
};
const Joint JOINTS[CHANNELS] = {
  {"FL shoulder", 90}, {"FL hip", 120}, {"FL knee", 180},
  {"FR shoulder", 90}, {"FR hip", 60},  {"FR knee", 0},
  {"RL shoulder", 90}, {"RL hip", 120}, {"RL knee", 180},
  {"RR shoulder", 90}, {"RR hip", 60},  {"RR knee", 0},
};

uint16_t degToUs(float deg) {
  if (deg < 0) deg = 0;
  if (deg > 180) deg = 180;
  return US_MIN + (uint16_t)(deg * (US_MAX - US_MIN) / 180.0f + 0.5f);
}

void setUs(uint8_t ch, uint16_t us) {
  pwm.writeMicroseconds(ch, us);
}

void off(uint8_t ch) {
  pwm.setPWM(ch, 0, 4096);  // full off: no pulses, the servo goes limp
}

void report(uint8_t ch, float deg) {
  Serial.print("  ch ");
  Serial.print(ch);
  Serial.print(" (");
  Serial.print(JOINTS[ch].name);
  Serial.print(") -> ");
  Serial.print(deg, 0);
  Serial.print(" deg, ");
  Serial.print(degToUs(deg));
  Serial.println(" us");
}

void help() {
  Serial.println();
  Serial.println("servo_tool commands:");
  Serial.println("  c            centre all (90 deg)");
  Serial.println("  a [ch]       assembly angles (all, or one channel)");
  Serial.println("  s ch deg     set angle 0-180");
  Serial.println("  u ch us      set pulse 500-2500 us");
  Serial.println("  t ch         test sweep");
  Serial.println("  o [ch]       outputs off (all, or one channel)");
  Serial.println("Channel map (assembly angle):");
  for (uint8_t i = 0; i < CHANNELS; i++) {
    Serial.print("  ");
    if (i < 10) Serial.print(' ');
    Serial.print(i);
    Serial.print("  ");
    Serial.print(JOINTS[i].name);
    Serial.print("  ");
    Serial.println(JOINTS[i].assembly_deg);
  }
}

bool validChannel(long ch) {
  if (ch < 0 || ch >= CHANNELS) {
    Serial.println("  channel must be 0-11");
    return false;
  }
  return true;
}

void sweep(uint8_t ch) {
  Serial.print("  sweeping ch ");
  Serial.println(ch);
  for (int rep = 0; rep < 2; rep++) {
    for (int d = 90; d <= 135; d++) { setUs(ch, degToUs(d)); delay(15); }
    for (int d = 135; d >= 45; d--) { setUs(ch, degToUs(d)); delay(15); }
    for (int d = 45; d <= 90; d++) { setUs(ch, degToUs(d)); delay(15); }
  }
  report(ch, 90);
}

void handle(String line) {
  line.trim();
  if (line.length() == 0) return;
  char cmd = tolower(line.charAt(0));
  String rest = line.substring(1);
  rest.trim();
  int space = rest.indexOf(' ');
  bool hasA = rest.length() > 0;
  long a = hasA ? rest.toInt() : -1;
  bool hasB = space > 0;
  long b = hasB ? rest.substring(space + 1).toInt() : -1;

  switch (cmd) {
    case 'h':
    case '?':
      help();
      break;
    case 'c':
      Serial.println("Centre all:");
      for (uint8_t i = 0; i < CHANNELS; i++) { setUs(i, degToUs(90)); report(i, 90); delay(60); }
      break;
    case 'a':
      if (hasA) {
        if (!validChannel(a)) break;
        setUs(a, degToUs(JOINTS[a].assembly_deg));
        report(a, JOINTS[a].assembly_deg);
      } else {
        Serial.println("Assembly angles:");
        for (uint8_t i = 0; i < CHANNELS; i++) {
          setUs(i, degToUs(JOINTS[i].assembly_deg));
          report(i, JOINTS[i].assembly_deg);
          delay(60);  // stagger the starts so the rail doesn't see twelve inrush spikes at once
        }
      }
      break;
    case 's':
      if (!hasB) { Serial.println("  usage: s <ch> <deg>"); break; }
      if (!validChannel(a)) break;
      setUs(a, degToUs(b));
      report(a, constrain(b, 0, 180));
      break;
    case 'u':
      if (!hasB) { Serial.println("  usage: u <ch> <us>"); break; }
      if (!validChannel(a)) break;
      b = constrain(b, US_MIN, US_MAX);
      setUs(a, b);
      Serial.print("  ch ");
      Serial.print(a);
      Serial.print(" -> ");
      Serial.print(b);
      Serial.println(" us");
      break;
    case 't':
      if (!hasA) { Serial.println("  usage: t <ch>"); break; }
      if (!validChannel(a)) break;
      sweep(a);
      break;
    case 'o':
      if (hasA) {
        if (!validChannel(a)) break;
        off(a);
        Serial.print("  ch ");
        Serial.print(a);
        Serial.println(" off");
      } else {
        for (uint8_t i = 0; i < 16; i++) off(i);
        Serial.println("  all outputs off");
      }
      break;
    default:
      Serial.println("  unknown command; type h for help");
  }
}

void setup() {
  Serial.begin(115200);
  Wire.begin();
  // The shield ties A4/A5 to SDA/SCL. Leave A4/A5 unused (and don't call Wire2.begin()).
  if (!pwm.begin()) {
    Serial.println("PCA9685 not found at 0x40. Check the shield is seated and SJ1 is soldered.");
  }
  pwm.setOscillatorFrequency(25000000);
  pwm.setPWMFreq(50);
  for (uint8_t i = 0; i < 16; i++) off(i);
  delay(500);
  Serial.println("servo_tool ready. All outputs off.");
  help();
}

void loop() {
  if (Serial.available()) {
    handle(Serial.readStringUntil('\n'));
  }
}
