beriberikix/spotmicro-arduino-q/(commit log)

2026-11-09 Scaffold spot-unoq: UNO Q electronics bay for SpotMicroESP32
    Full FreeCAD assembly linking Kubina's SpotMicroESP32 model, a new
    parametric mounting plate for the Arduino UNO Q, PCA9685, GY-521 and a
    Pololu D24V150F6 servo regulator, plus README, BOM, licenses and
    scripts to fetch the third-party CAD.
    [SpotUnoQ.FCStd, UnoQ_Mountingplate.FCStd, UnoQ_Mountingplate.step, UnoQ_Mountingplate.stl]
2026-11-09 BOM: MG996R option, regulator dropout and current; confirm upstream licenses
2026-11-09 BOM: link HOOYIJ DS3218 180° 4-pack
2026-11-09 Add helper stand as optional print; track future ideas in docs/ideas.md
2026-11-09 Host all printable STLs; make robjk reinforced shoulders standard
    stl/ now holds every part with a generated parts list (quantities,
    mirrored copies, material, infill), built by scripts/export_stls.py from
    Kooba's and robjk's CC BY files, Leika's helper stand and the new plate.
    robjk's shoulder joint and upper-leg shell replace Kooba's; 625ZZ count
    goes to 12.
    [Bottom_Cover_Split_Front.stl, Bottom_Cover_Split_Rear.stl, Bottom_Shoulder.stl, Cameramount_ESP32_CAM.stl, Cameramount_ESP32_CAM_Counterpiece.stl, Chassis_Side.stl, Foot_Tip.stl, Front_Cover_Optimized.stl]
2026-11-09 CAD: fit robjk reinforced shoulders into the assembly
    Upper-leg shells, extended caps, shoulder covers and extended servo mounts
    replace Kubina's originals on all four legs. Parts were placed by fitting
    them to Kubina's geometry; the cover bearing bores lie on the shoulder servo
    axes within 0.3 mm.
    [SpotUnoQ.FCStd]
2026-11-09 NOTICE: robjk geometry embedded in the assembly
2026-11-09 BOM: describe robjk bearing pins and add their nuts
    [UnoQ_Mountingplate.step]
2026-11-09 MakerWorld: build a sliced 10-plate Bambu Studio project; normalize STLs
    stl/ parts are now centred with their lowest point at Z = 0, and robjk's
    shoulder cover and extended cap are stored in print orientation.
    scripts/build_makerworld_3mf.py drives the Bambu Studio CLI with flattened
    system presets and an assemble list: per-plate auto-arrange, per-part
    filament and infill, slicing, and a check that every part was sliced.
    [Bottom_Cover_Split_Front.stl, Bottom_Cover_Split_Rear.stl, Bottom_Shoulder.stl, Cameramount_ESP32_CAM.stl, Cameramount_ESP32_CAM_Counterpiece.stl, Chassis_Side.stl, Foot_Tip.stl, Front_Cover_Optimized.stl]
2026-11-10 MakerWorld build: set each object's filament so Bambu Studio shows black/white/TPU
2026-11-10 MakerWorld build: textured PEI plate (P1S stock)
2026-11-10 MakerWorld build: settings Bambu Studio keeps; 3 walls on structural plates
    Record the 20% infill in different_settings_to_system so the app doesn't reload
    the preset's 15%, move per-part overrides (100% cover infill, filament) to the
    object level where the app shows them, and give load-bearing plates 3 walls.
    [build_makerworld_3mf.py]
2026-11-10 Add fit-test print set
    UNO Q and Pololu mount test frames cut from the electronics plate, and a
    --test-prints build: 2 plates (black, white) with one of each part that mates
    with a bought component.
    [Pololu_Mount_Test.stl, UnoQ_Mount_Test.stl, UnoQ_Mountingplate.step]
2026-11-10 Document the fit-test prints
2026-11-10 Add STEP versions of the printable parts
    scripts/export_steps.py fits each designer's FreeCAD solid to the hosted STL
    (registration + point-to-surface check) and writes step/, mirroring stl/,
    including mirrored copies. 31 parts, 37 files.
    [Bottom_Cover_Split_Front.step, Bottom_Cover_Split_Rear.step, Bottom_Shoulder.step, Cameramount_ESP32_CAM.step, Cameramount_ESP32_CAM_Counterpiece.step, Chassis_Side.step, Foot_Tip.step, Front_Cover_Optimized.step]
2026-11-10 Exploded-view macro; fix corrupted robjk solids in the assembly
    scripts/explode_animation.FCMacro renders the turntable loop at 2x, scales it
    down for smooth edges and encodes a 1080p MP4 and an undithered GIF.
    The robjk shells, caps and covers in cad/SpotUnoQ.FCStd had been placed with
    transformGeometry, which converted them to B-splines and left invalid solids
    (the shells lost 10% of their volume and rendered a stray arc near the knee).
    They are rebuilt with rigid transforms (mirror + rotation for the right side),
    valid and at 100% volume, in the same positions. Renders regenerated.
    [SpotUnoQ.FCStd]
2026-11-10 README: rename heading to SpotMicro for Arduino UNO Q
2026-11-10 Add Media Carrier + dual camera variant
    Variant electronics: Arduino UNO Media Carrier under the UNO Q, Adafruit
    16-channel servo shield (#1411) with right-angle servo headers, SZBK07
    buck, and two Raspberry Pi Camera Module 2s in the head.
    - cad/MediaCarrier_Mountingplate.FCStd: plate with carrier support pads,
    hooks and snap clips (the carrier has no mounting holes), SZBK07
    posts; Kooba's power-cable cap removed so the stack fits at the rear
    - cad/Sensormount_DualCam.FCStd: Kooba's sensor mount with two camera
    mounts (recess, M2 pilots, FOV-flared lens windows), Params-driven
    - cad/SpotUnoQ_MediaCarrier.FCStd: variant assembly with modelled
    camera cable routes (about 168 mm each;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
    [Carrier_Mount_Test.stl, MediaCarrier_Mountingplate.FCStd, MediaCarrier_Mountingplate.step, MediaCarrier_Mountingplate.stl, SZBK07_Mount_Test.stl, Sensormount_DualCam.FCStd, Sensormount_DualCam.step, Sensormount_DualCam.stl]
2026-11-10 Variant head: fill the ESP32-CAM openings, re-route camera cables
    - Sensormount_DualCam: remove Kooba's ESP32-CAM lens and flash lofts so
    the front shows only the two camera windows (fillet refs re-matched)
    - Camera cables: the earlier clearance check skipped the head mount, and
    the route clipped its lower lip; the sideways jog is now a flat folded
    run behind the head. About 172 mm each, still 200 mm cables
    - Re-exported STL/STEP and head render; docs and NOTICE updated
    [Sensormount_DualCam.FCStd, Sensormount_DualCam.step, Sensormount_DualCam.stl, SpotUnoQ_MediaCarrier.FCStd]
2026-11-10 Make the Media Carrier + cameras design the main build
    The servo shield, SZBK07, UNO Media Carrier and two Camera Module 2s
    replace the PCA9685 breakout, Pololu D24V150F6, HC-SR04s and ESP32-CAM
    mount outright instead of living alongside them as a variant.
    - cad/SpotUnoQ.FCStd and cad/UnoQ_Mountingplate.FCStd now hold the new
    assembly and plate; the variant copies are gone
    - stl/ and step/: new plate and Sensormount_DualCam in electronics/ and
    head/; old head parts and UNO Q/Pololu fit tests removed; our STEPs
    are written by export_stls.py (cad/export/ removed)
    - Fit tests: Carrier_Mount_Test, SZBK07_Mount_Test and the camera mount
    - MakerWorld build script updated (full robot 32.3 h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
    [Cameramount_ESP32_CAM.step, Cameramount_ESP32_CAM.stl, Cameramount_ESP32_CAM_Counterpiece.step, Cameramount_ESP32_CAM_Counterpiece.stl, Carrier_Mount_Test.stl, MediaCarrier_Mountingplate.FCStd, MediaCarrier_Mountingplate.stl, Pololu_Mount_Test.stl]
2026-11-10 Docs: describe what's built; move lineage to docs/background.md
    - README, BOM and ideas now describe the robot as it is, in shorter
    copy, with one credit line pointing to the new background doc
    - docs/background.md collects the project lineage, the ESP32-to-UNO Q
    changes, changes to upstream parts, servo experience and helper-stand
    notes
    - Re-rendered the reinforced-shoulder image from the current assembly
2026-11-11 BOM: DS3218 on all joints, 180° buying notes
    Link the Miuzei 180° 4-pack, warn about 270° listings, and drop the
    MG996R comparison table. Fit tests ask for one DS3218.
2026-11-13 Add step-by-step assembly guide site (draft)
    Astro Starlight site in site/, deployed to GitHub Pages by
    .github/workflows/pages.yml on pushes to main.
    - 30 pages: prep, legs, shoulders, body, electronics, covers, with
    placeholders for power-on, calibration and firmware
    - CAD renders per step (animation, exploded, assembled) generated by
    scripts/render_guide.FCMacro from cad/SpotUnoQ.FCStd
    - Interactive servo channel map, wiring diagram, check-offs with a
    progress tracker, and a 3D model viewer (scripts/export_guide_glb.py)
    - firmware/servo_tool: UNO Q sketch to test servos and set assembly angles
    - Purple placeholders list the photos and videos to shoot (reference/media-todo)
    - stl/RE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
2026-11-13 Guide: make the render view buttons switch views and line up
    Starlight's content styles set display:block on images and videos, which
    overrode the hidden attribute, so all three views stayed stacked and the
    Assembled image always showed. They also added a top margin to every
    button after the first. Mark the figure not-content and force hidden
    views to display:none.
2026-11-14 Guide: photos of all ten printed plates on the prints page
    Cropped, metadata-stripped photos of each MakerWorld plate, so builders can count their parts before cleanup.
